GioByte10/American-Sign-Language-Glove/asl_glove_presentation.pdf

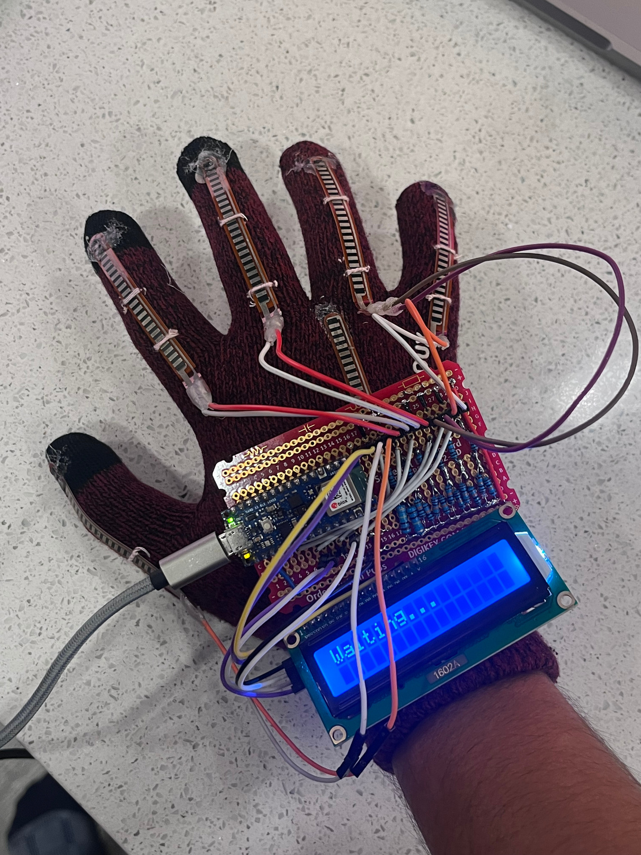
[picture p9: figure]

# A S L G L O V E

Dehao Lin
Giovanni Bernal Ramirez
Li-Pin Chang
So Hirota

# T E A M

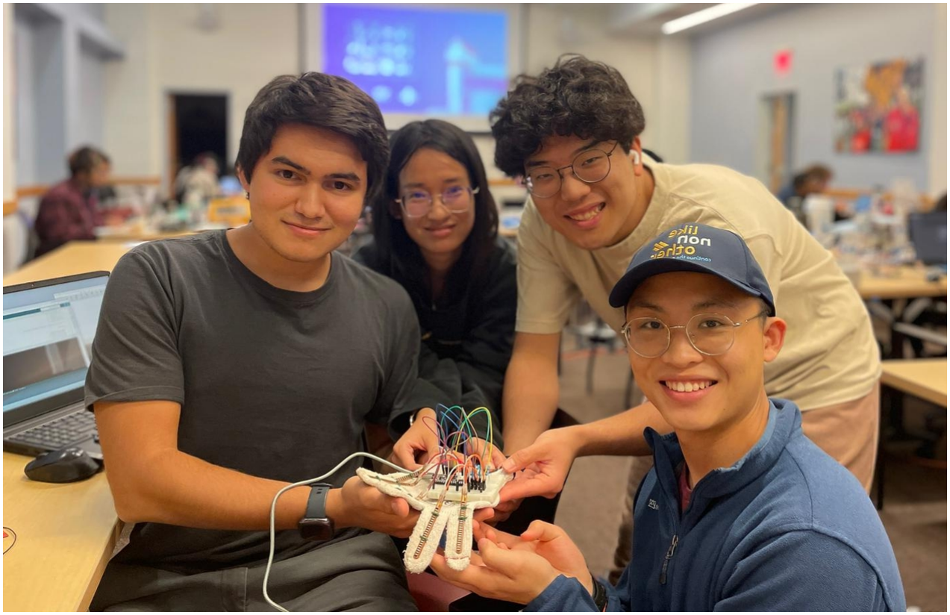
[picture p10: figure]

Giovanni Bernal Ramirez | Li-Pin Chang | So Hirota | Dehao Lin
MechE | MechE | DCS | MechE

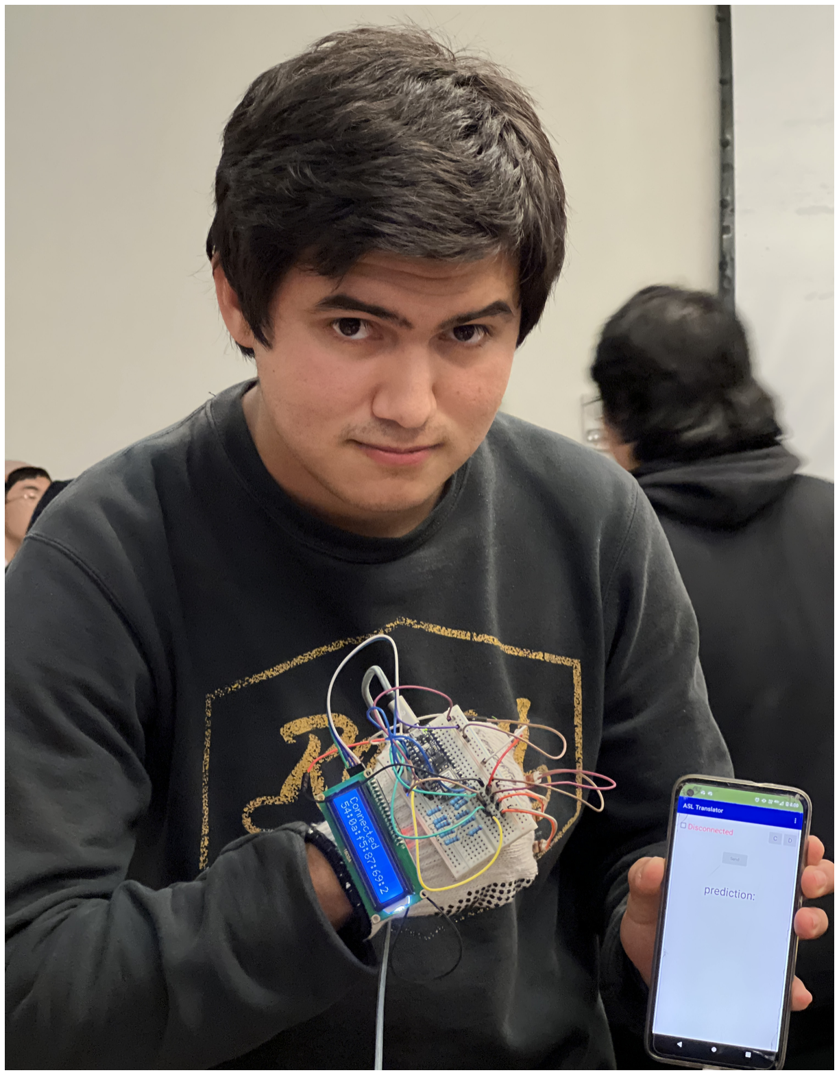
[picture p11: figure]

# O V E R V I E W

Improve general communication for the deaf community
Students to understand ASL Practice ASL gesture

A glove that can transcribe American Sign Language alphabets and display on a cellphone App and an LCD screen through Bluetooth Low Energy.

1.

2.
3.

# K E Y F E A T U R E S

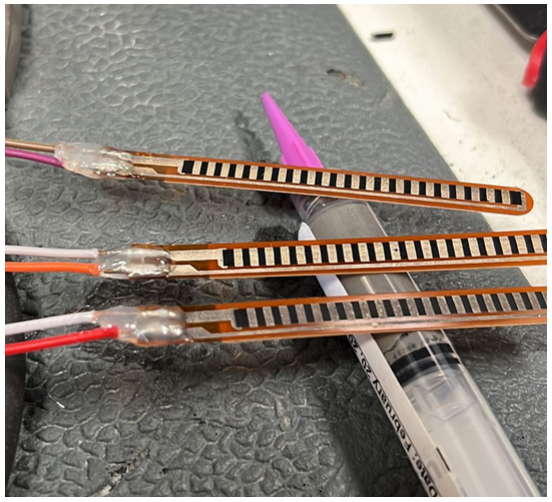
[picture p12: figure]
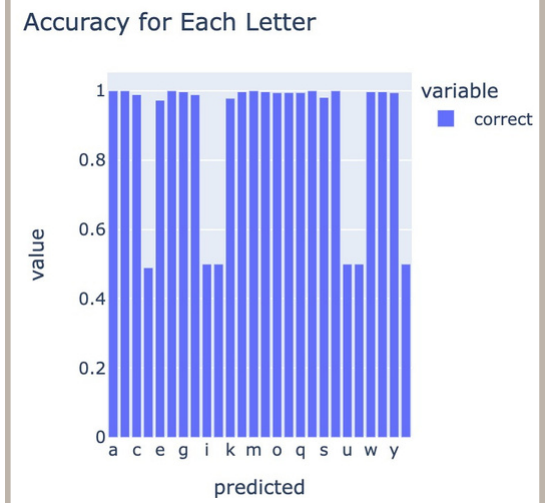
[picture p13: figure]

Flex Sensor | KNN Algorithm

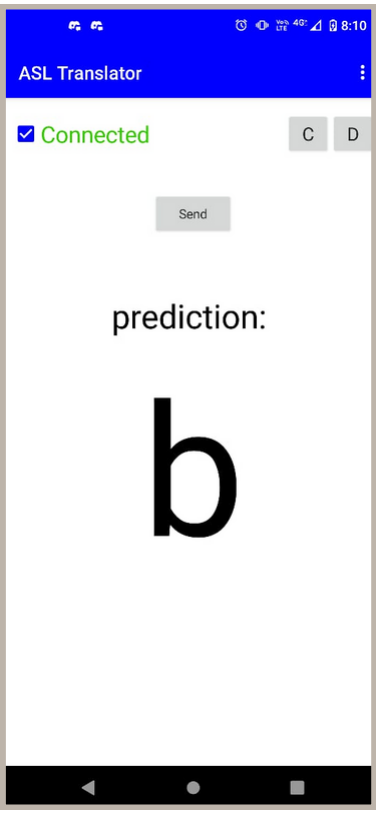
[picture p14: figure]

Mobile App | BLE

# I T E R A T I O N S

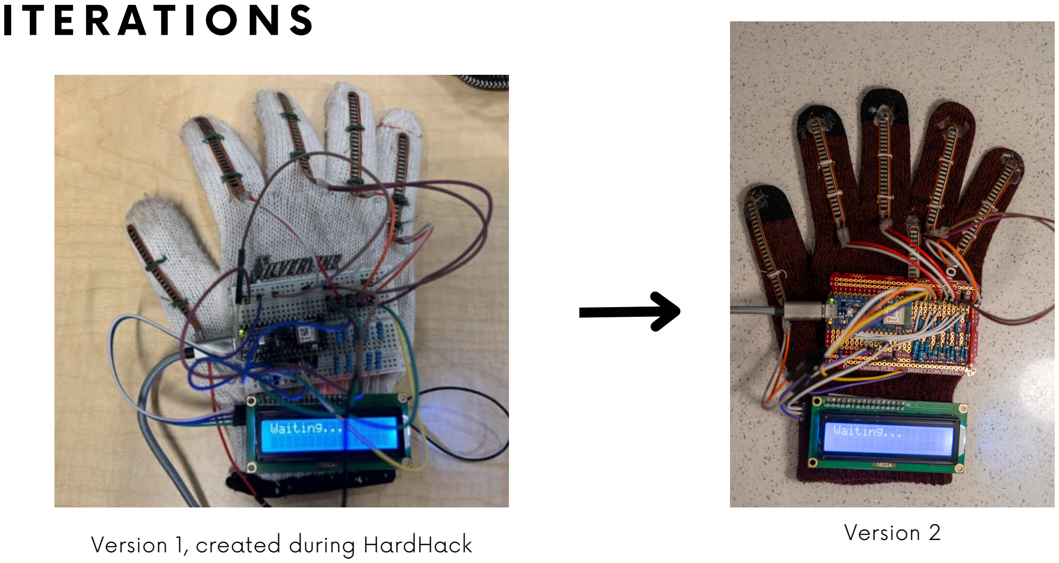
[picture p15: page 5]

Version 1, created during HardHack

Version 2

# I M P R O V E M E N T S

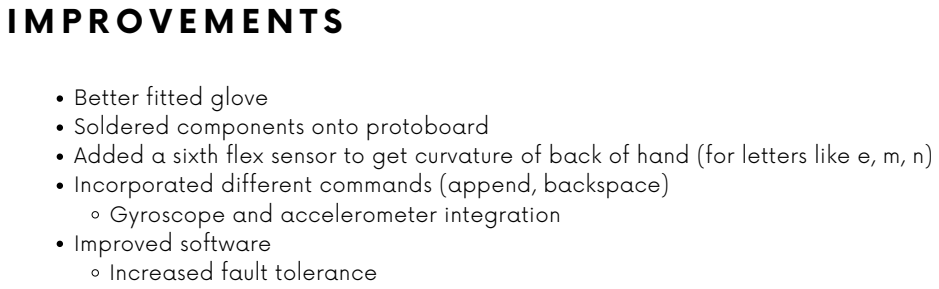
[picture p16: page 6]

Better fitted glove
Soldered components onto protoboard
Added a sixth flex sensor to get curvature of back of hand (for letters like e, m, n)
Incorporated different commands (append, backspace)
Gyroscope and accelerometer integration
Improved software
Increased fault tolerance

# F L O W

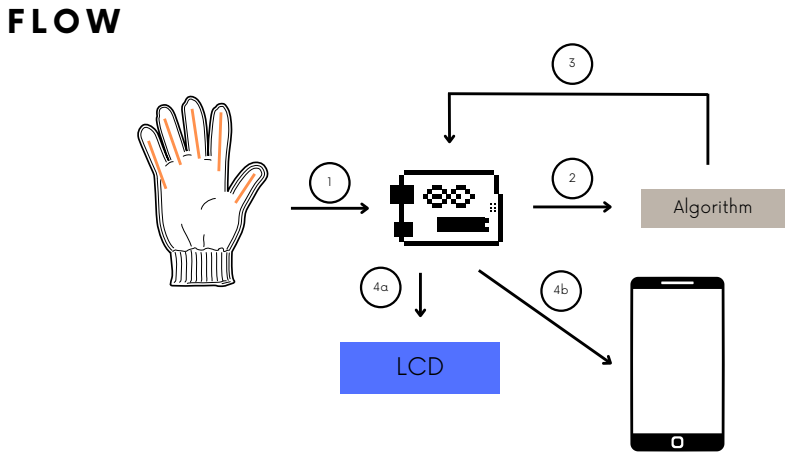
[picture p17: page 7]
LCD; Algorithm

# S C H E M A T I C S

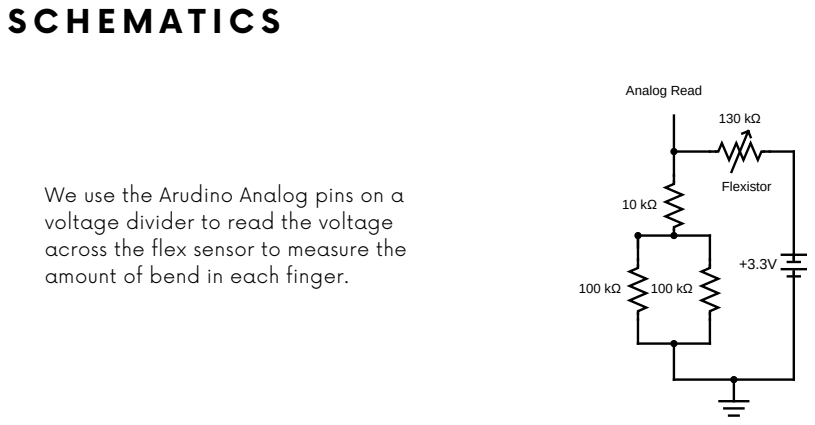
[picture p18: page 8]
Analog Read; Flexistor

We use the Arudino Analog pins on a
voltage divider to read the voltage
across the flex sensor to measure the
amount of bend in each finger.

# F I N D I N G T H E O P T I M A L R E S I S T A N C E

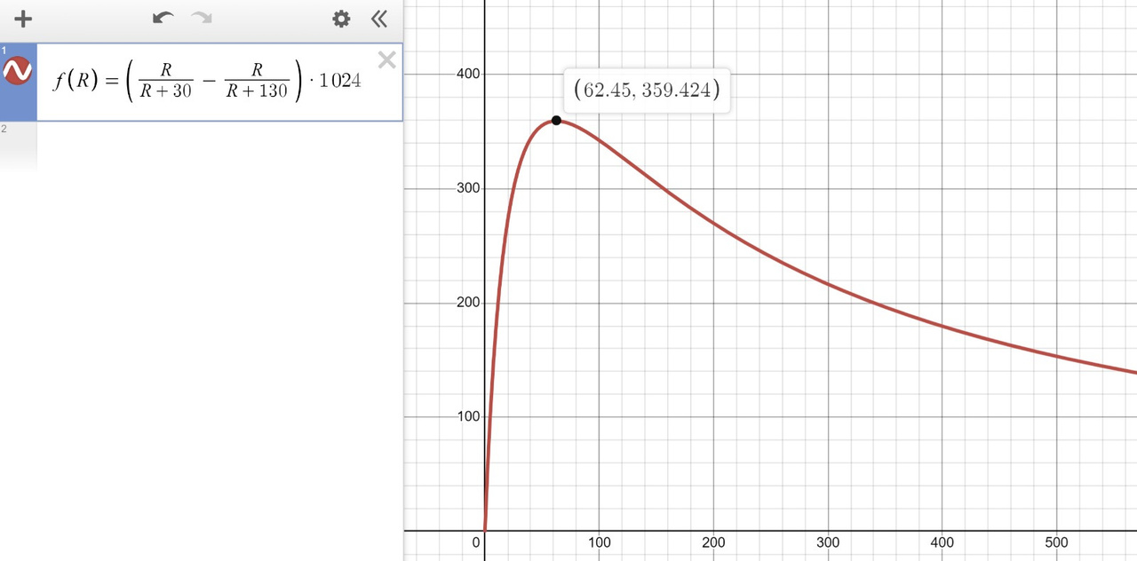
[picture p19: figure]

We calculated the optimal fixed resistance between the analog pins and ground that would produce the greatest range of values.
Getting a wide range of values enables the algorithm to make more precise predictions.

# C O M M A N D S

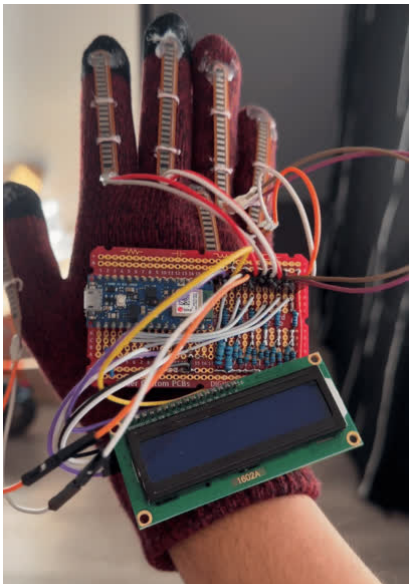
[picture p20: figure]
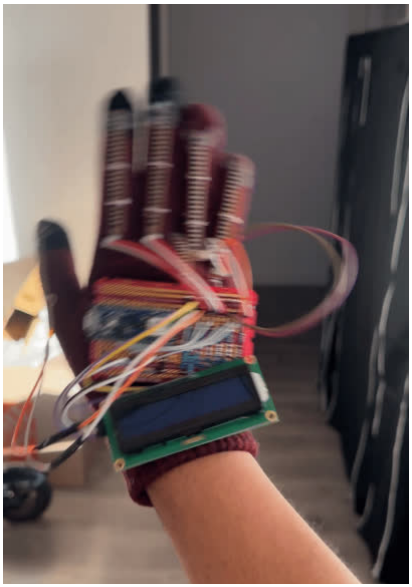
[picture p21: figure]

Append | Backspace

Gyroscopic data was sent to the laptop, alongside the flex sensor data. We set thresholds for the gyroscopic data to trigger these commands.

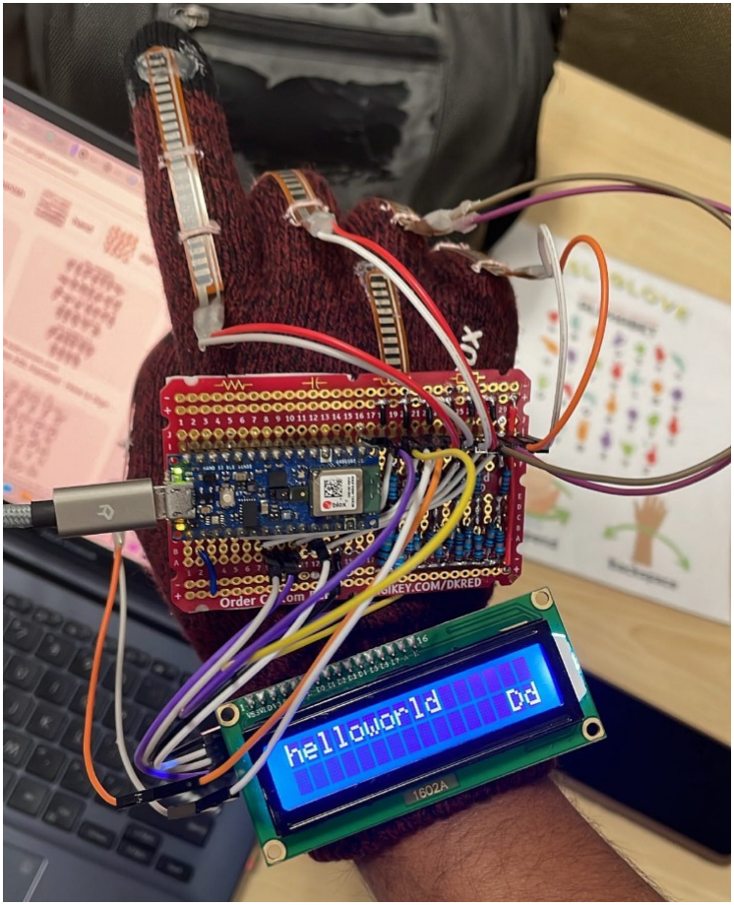
[picture p22: figure]

# C A P A B I L I T I E S

## Hello World！

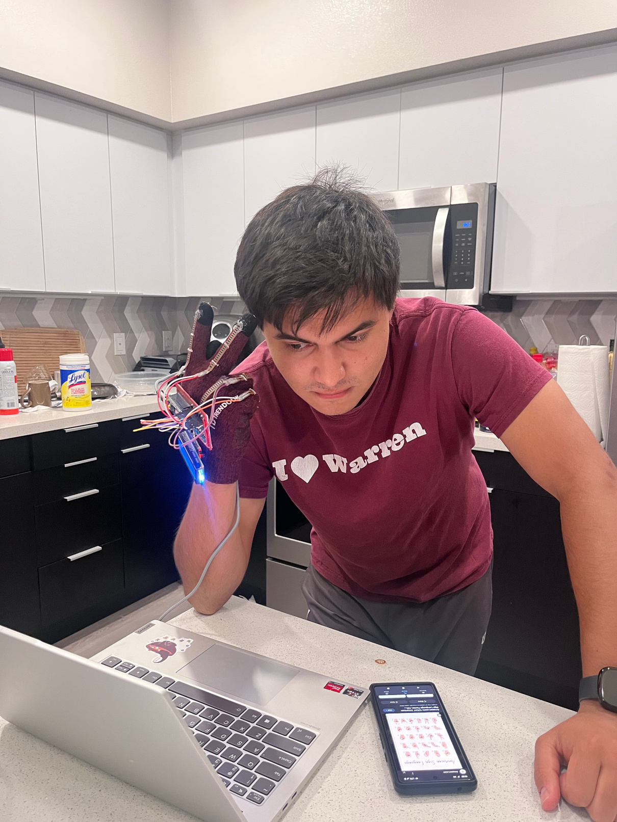
[picture p23: figure]

# D A T A C O L L E C T I O N

### Each person took turn wearing the glove and signed each alphabet

for 1 minute.

### Used PuTTy to save sensor data as a csv file

# F O R T H E F U T U R E

Adding additional IMU data to allow for recognization of words
Adding additional sensors to improve reliability of recognizing certain letters hall effect for u, v

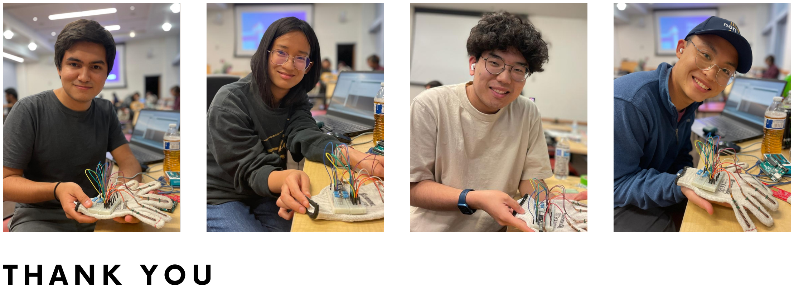
[picture p24: page 14]

# T H A N K Y O U
