GioByte10/American-Sign-Language-Glove/_assets/ble_model_h.png

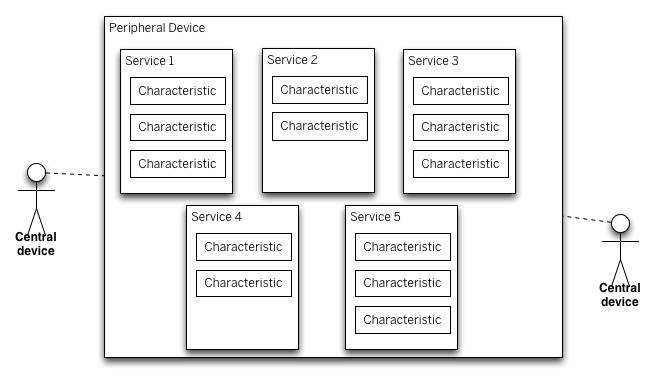
_assets/ble_model_h.png
