GioByte10/American-Sign-Language-Glove/_assets/Glove.jpg

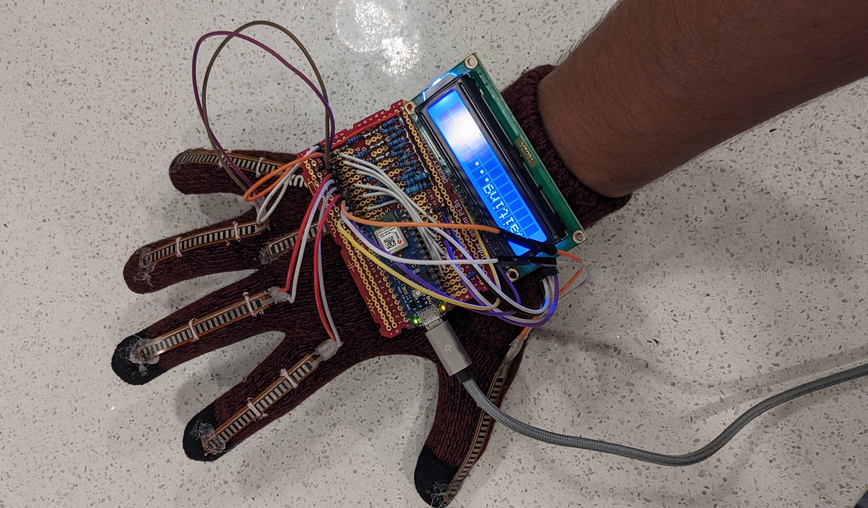
_assets/Glove.jpg
