GioByte10/American-Sign-Language-Glove/(commit log)

2023-11-27 Added KNN
    [a2.csv, c2.csv]
2025-06-04 Added Arduino ASL
2025-06-04 Removed some prints
